drsanyo/CWWebBeakonESP8266/Web-Beacon-sch.png

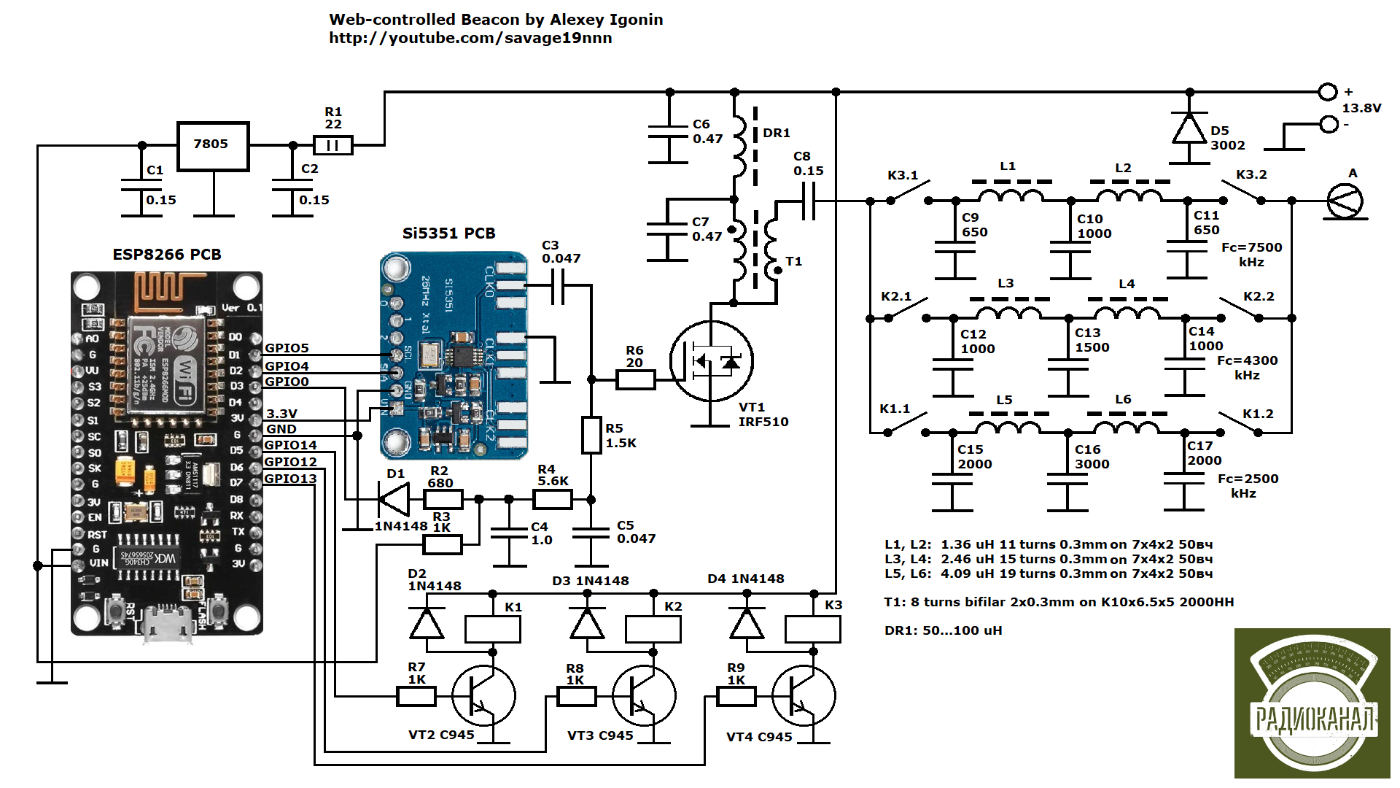
Web-Beacon-sch.png
